lakadkarr/Plant-Vital-Monitoring-PCB-Design-Wireless-Firmware-/Debugging_Ackbit_Missing.jpeg

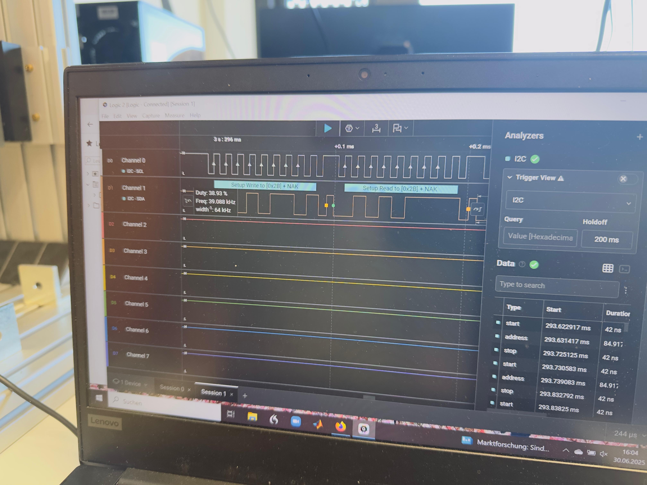
Debugging_Ackbit_Missing.jpeg
