lakadkarr/Plant-Vital-Monitoring-PCB-Design-Wireless-Firmware-/Hardware_Wiring.jpeg

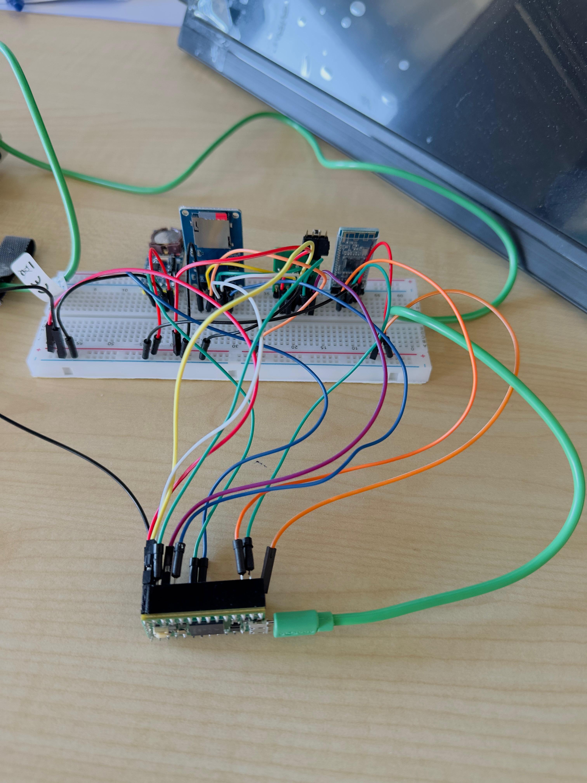
Hardware_Wiring.jpeg
