lakadkarr/Plant-Vital-Monitoring-PCB-Design-Wireless-Firmware-/BT05_Bluetooth_Module.jpeg

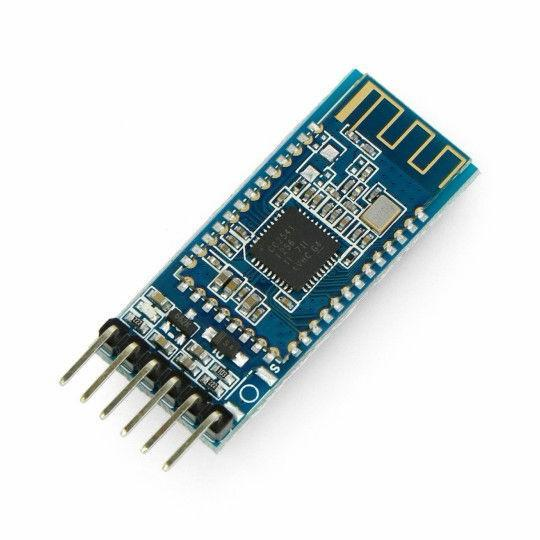
BT05_Bluetooth_Module.jpeg
