lakadkarr/Plant-Vital-Monitoring-PCB-Design-Wireless-Firmware-/Data_MobileAPP.jpeg

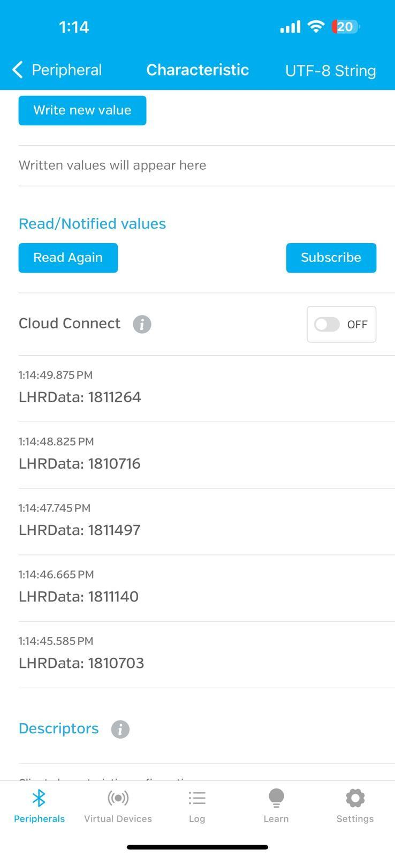
Data_MobileAPP.jpeg
