lakadkarr/Plant-Vital-Monitoring-PCB-Design-Wireless-Firmware-/Debbuging_logic_Analyzer.jpeg

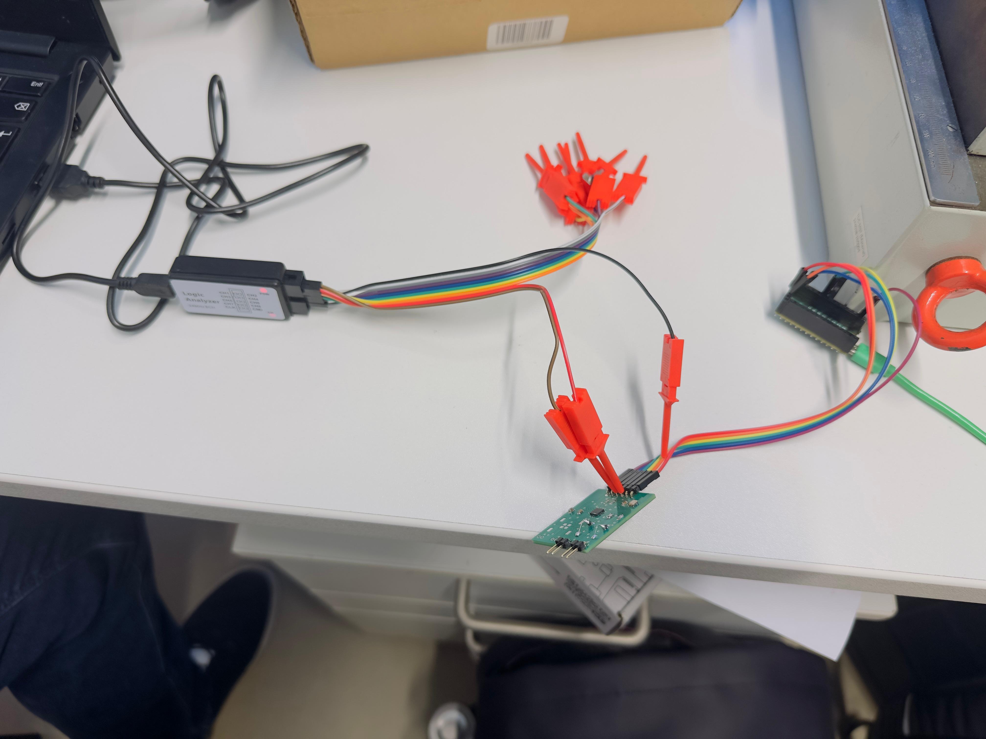
Debbuging_logic_Analyzer.jpeg
