lakadkarr/Plant-Vital-Monitoring-PCB-Design-Wireless-Firmware-/FDC2214_brd.png

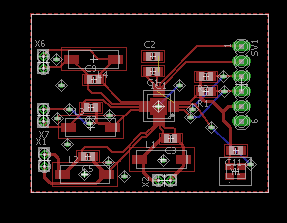
FDC2214_brd.png
