lakadkarr/Plant-Vital-Monitoring-PCB-Design-Wireless-Firmware-/FDC2214_sch.png

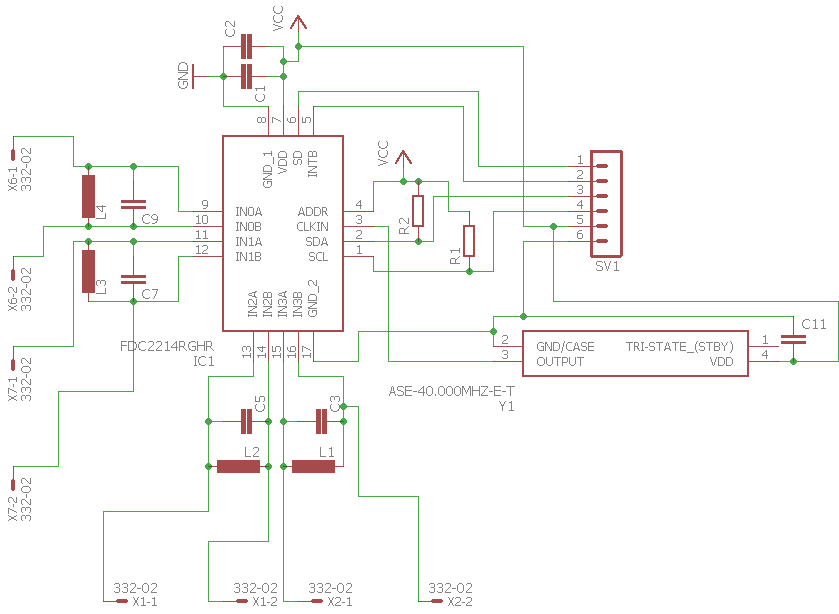
FDC2214_sch.png
