lakadkarr/Plant-Vital-Monitoring-PCB-Design-Wireless-Firmware-/FDC_PCB_Designed.jpeg

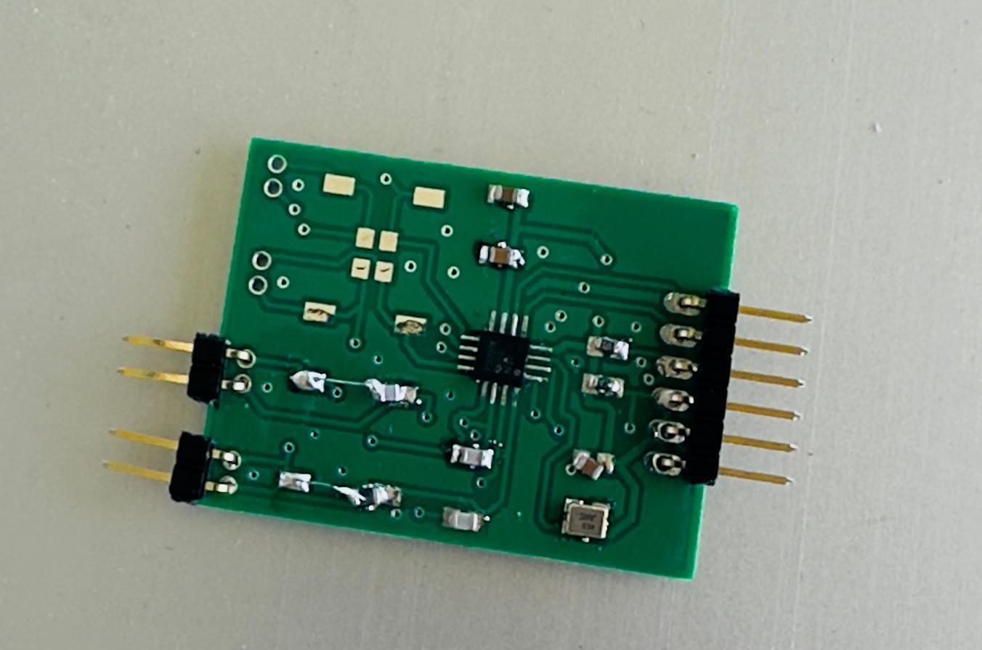
FDC_PCB_Designed.jpeg
