lakadkarr/Plant-Vital-Monitoring-PCB-Design-Wireless-Firmware-/LDC1101_brd.png

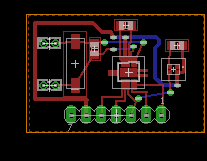
LDC1101_brd.png
