lakadkarr/Plant-Vital-Monitoring-PCB-Design-Wireless-Firmware-/LDC_1101_sch.png

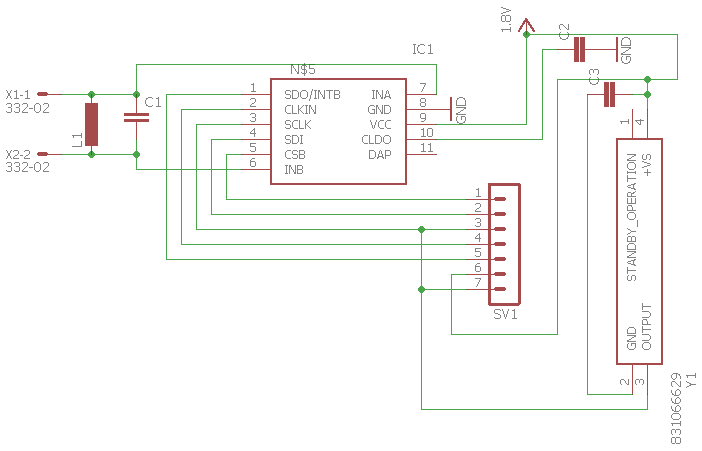
LDC_1101_sch.png
