lakadkarr/Plant-Vital-Monitoring-PCB-Design-Wireless-Firmware-/LDC_PCB_Designed.jpeg

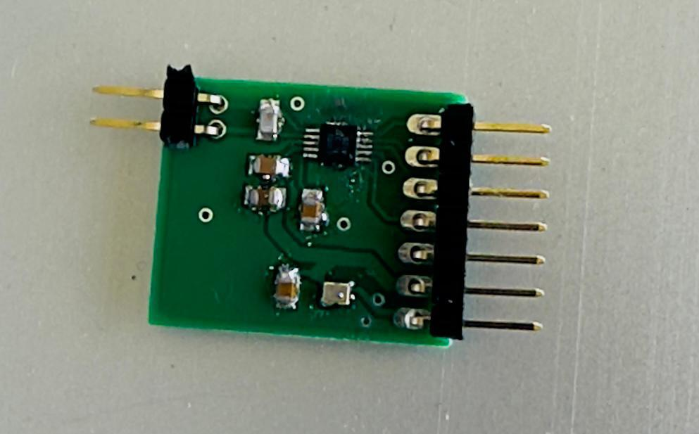
LDC_PCB_Designed.jpeg
