lakadkarr/Plant-Vital-Monitoring-PCB-Design-Wireless-Firmware-/RTC_HW_689.jpeg

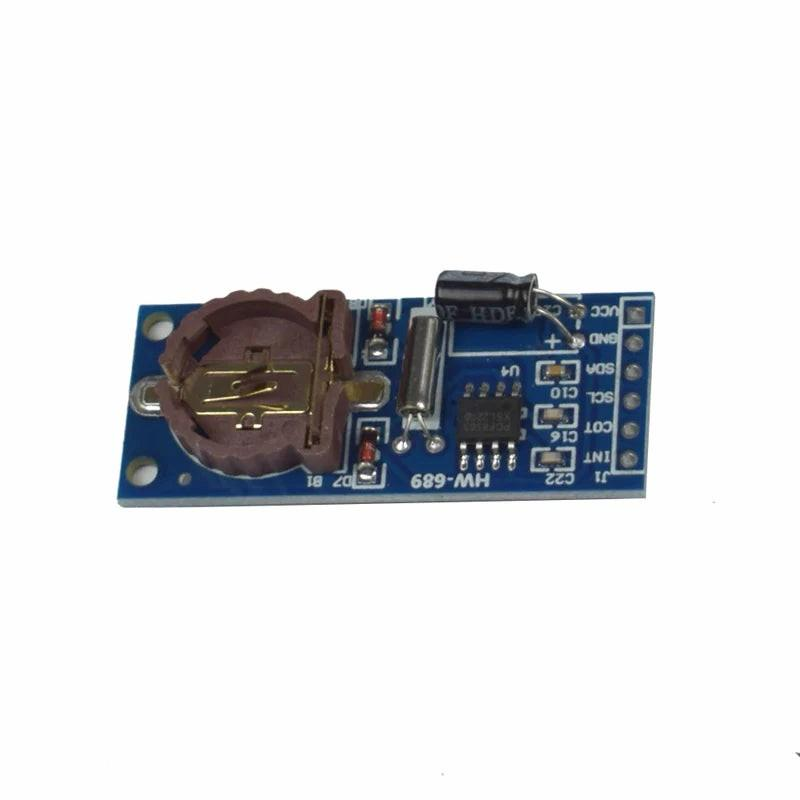
RTC_HW_689.jpeg
