lakadkarr/Plant-Vital-Monitoring-PCB-Design-Wireless-Firmware-/SD_Card_Adapter.jpeg

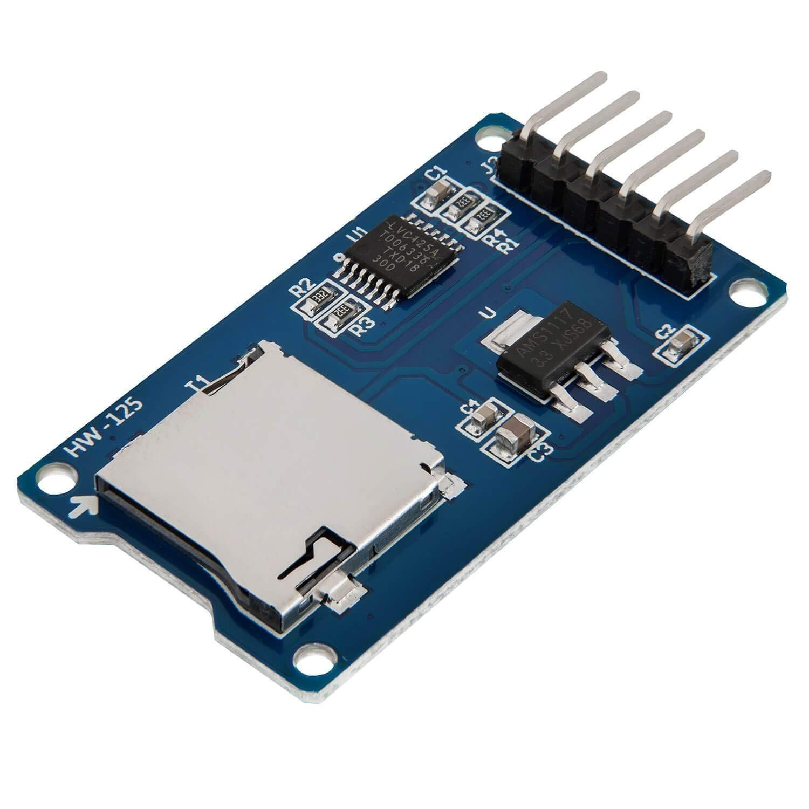
SD_Card_Adapter.jpeg
