lakadkarr/Plant-Vital-Monitoring-PCB-Design-Wireless-Firmware-/(commit log)

2026-06-19 Add SPI communication and SD card handling
    This file contains the implementation of SPI communication with the LDC1101, including setup for SD card and RTC functionalities.
2026-06-19 Implement LDC1101 setup and SD card logging
    This code initializes and configures the LDC1101 sensor, sets up an SD card for data logging, and implements Bluetooth output for LHR data.
2026-06-19 Update Teensy 4.0 section in README
2026-06-19 Add FDC2214 I2C driver for Teensy 4.0
    Implement I2C driver functions for FDC2214.
2026-06-19 Add files via upload
    This module receives data directly from the Teensy 4.0 microcontroller.
2026-06-19 Add files via upload
    BT05 module facilitates wireless data transmission to smartphones or PCs.
2026-06-19 Update PCB file paths in README.md
2026-06-19 Add files via upload
    Designed PCB with soldering.
2026-06-19 Modify image references in README
    Updated image links for schematic screenshots and PCB renders.
2026-06-19 Add FDC2214 sensor initialization and data reading
2026-06-19 Add files via upload
    This report presents the design and implementation of a **Plant Vital Monitoring System** developed using industrial sensing technologies and embedded systems. The project focuses on non-invasive monitoring of plant health by integrating inductive and capacitive sensing techniques for real-time data acquisition and analysis.
    The system is built around a **Teensy 4.0 microcontroller** and incorporates the **LDC1101 inductive sensor**, **FDC2214 capacitive sensor**, **RTC module**, **SD card data logging**, and **Bluetooth communication**. Sensor data is continuously collected, timestamped, stored locally, and transmitted wirelessly for monitoring purposes.
    The repor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
2026-06-19 Add files via upload
    This report presents the design and implementation of a "plant vital monitoring system" developed using industrial sensing technologies and embedded systems. The project focuses on non-invasive monitoring of plant health by integrating inductive and capacitive sensing techniques for real-time data acquisition and analysis.
    The system is built around a Teensy 4.0 microcontroller and incorporates the LDC1101 inductive sensor, FDC2214 capacitive sensor, RTC module, SD card data logging, and Bluetooth communication. Sensor data is continuously collected, timestamped, stored locally, and transmitted wirelessly for monitoring purposes.
    The report covers the complete deve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
