lakadkarr/Plant-Vital-Monitoring-PCB-Design-Wireless-Firmware-/(notices)

Notices in the files:
README.md:
License: Academic
